szczys/Binary-Burst-Clock/board/v1-brd.png

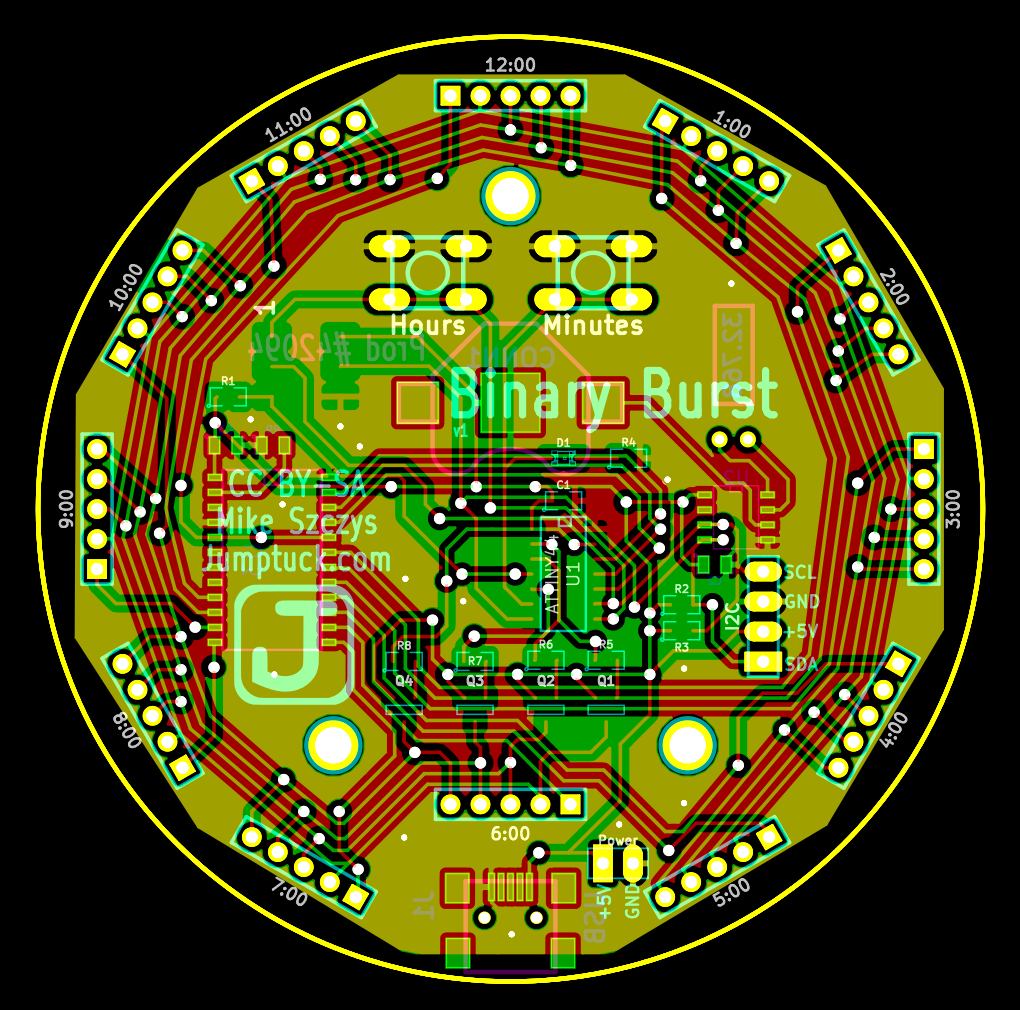
board/v1-brd.png
