szczys/Binary-Burst-Clock/board/v1-sch.png

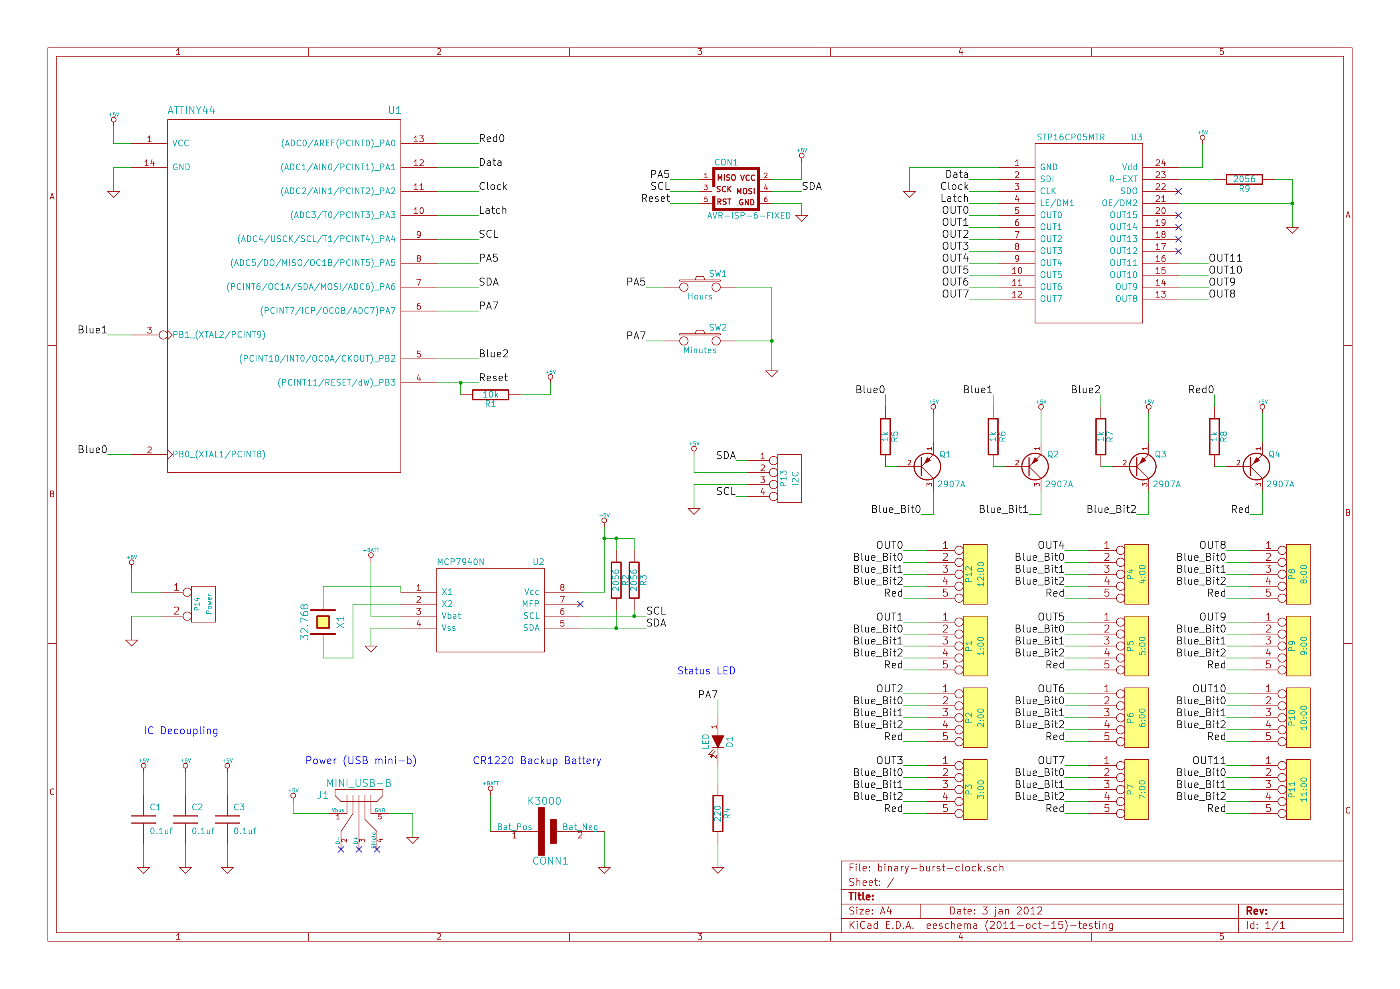
board/v1-sch.png
