szczys/Binary-Burst-Clock/board/binary-burst-clock.sch

## KiCad design board/binary-burst-clock.sch (2012-01-03)

Schematic: binary-burst-clock.sch

Parts:
C1, C2, C3: 0.1uf
CON1: AVR-ISP-6-FIXED; AVR_ISP_6-fixed
CONN1: K3000
D1: LED
J1: MINI_USB-B
P1: 1:00
P2: 2:00
P3: 3:00
P4: 4:00
P5: 5:00
P6: 6:00
P7: 7:00
P8: 8:00
P9: 9:00
P10: 10:00
P11: 11:00
P12: 12:00
P13: I2C
P14: Power
Q1, Q2, Q3, Q4: 2907A
R1: 10k
R2, R3, R9: 2056
R4: 220
R5, R6, R7, R8: 1k
SW1: Hours
SW2: Minutes
U1: ATTINY44
U2: MCP7940N
U3: STP16CP05MTR
X1: 32.768

Notes on the sheet:
Status LED
CR1220 Backup Battery
Power (USB mini-b)
IC Decoupling
