szczys/Binary-Burst-Clock/(commit log)

2011-12-17 Added libraries for sink driver and uC
2011-12-18 Continued work on schematic
    [binary-burst-clock.sch]
2011-12-18 More schematic work
    [binary-burst-clock.sch]
2011-12-18 Full schematic finished
    [binary-burst-clock.sch]
2011-12-23 All footprints created and assigned
    [binary-burst-clock.sch]
2011-12-24 Added PNG of the schematic
2011-12-26 Finished first version of PCB
    [binary-burst-clock.brd, binary-burst-clock.sch]
2011-12-31 Added I2C and power header; adjusted spacing
    [binary-burst-clock.brd, binary-burst-clock.sch]
2011-12-31 Widened all traces (rerouting as neccessary) and removed 10M resistor from USB shielding pin.
    [binary-burst-clock.brd, binary-burst-clock.sch]
2012-01-01 Added ground fills to both layers; Added logo and text
    [binary-burst-clock.brd]
2012-01-01 Fixed USB connector pinout; Adjusted solder stop of SOIC packages; moved labels on silk screen
    [binary-burst-clock.brd, binary-burst-clock.sch]
2012-01-01 Cleaned up, double-checked, and ordered parts
    [binary-burst-clock.brd]
2012-01-03 Added status LED; cleaned up GND traces
    [binary-burst-clock.brd, binary-burst-clock.sch]
2012-01-09 Increased via drill and pad sizes; ordered boards, reached version 1 of board
    [binary-burst-clock.brd]
2012-03-05 Added test code for v1 PCB
2012-03-17 Added I2C read from RTC
2012-04-30 Added BOM for PCB
    [binary-burst-clock-BOM.csv]
2012-05-31 Switched to Peter Fleury's software I2C library
2012-05-31 Added RTC initializion (start oscillator and enable Vbatt)
    [main.c]
2012-05-31 Added framework for button input
2012-06-01 Implemented buttons for setting times (rewrites RTC on each button press--need a better way)
2012-06-01 Replace clock_ticks delay with timer1 based flag
    [main.c]
